wulffern/rply_ex0_sky130nm/README.md

GDS
DRC
LVS/LPE

# Why
I wanted to create a step by step "tutorial" for 
the flow. Both to debug the tech setup, and to make it easier
for you to learn the tools. I use a simple current mirror as
the example.

Head over to [https://wulffern.github.io/rply_ex0_sky130nm/](https://wulffern.github.io/rply_ex0_sky130nm/) 
for the tutorial.

# Changelog

I've tagged the repo at each stage. That means you can 
checkout the 0.1.0 tag and do things yourself.

To checkout a specific stage, do 

``` bash
git checkout 0.1.0
```

| Tag | Status | Comment |
|:---|:---|:---|
| 0.1.0 | v | Fix readme |
| 0.2.0 | v | Made schematic |
| 0.3.0 | v | Typical simulation |
| 0.4.0 | v | Corner simulation |
| 0.5.0 | v | Made layout |
| 0.6.0 | v | DRC/LVS clean |
| 0.7.0 | v | Extracted parasitics |
| 0.8.0 | v | Simulated parasitics |
| 0.9.0 | v | Updated README |
| 1.0.0 | v | All done |
| 1.0.1 | v | Updated after student feedback |

# Posts 

| File | Comment |
|:----:|---|
| [/docs/_posts/2022-12-25-tutorial.markdown](/docs/_posts/2022-12-25-tutorial.markdown) | Full tutorial |
