wulffern/rply_ex0_sky130nm/paper.md

---
abstract: |
  Tutorial on Skywater130nm open source analog flow.
author:
- Carsten Wulff
title: Open Source Analog Flow for Skywater 130nm
documentclass: docs/IEEEtran
papersize: a4
fontsize: 10pt
classoption: journal
numbersection:
pandoc-latex-fontsize:
  - classes: [c, listing]
    size: footnotesize
---
