wulffern/rply_ex0_sky130nm/docs/index.md

---
# Feel free to add content and custom Front Matter to this file.
# To modify the layout, see https://jekyllrb.com/docs/themes/#overriding-theme-defaults

layout: home
---

I've made multiple posts on a variation of topics on this page.

If you're completely new, then I'd recommend you start with the following

1. [Tech](tech)
1. [Tools](tools)
1. [Open source analog integrated circuit flow on Skywater 130 nm](tutorial)
1. [Programming](programming)

## Posts
