wulffern/rply_ex0_sky130nm/docs/_posts/2022-12-26-how-ic.markdown

---
layout: post
title: How ICs are made 
categories: AIC
---

Over the past decade I've had various lectures for 1'st year, and other levels
at NTNU with an introduction to how we make integrated circuits. I've compiled
all those slidesets over the years into a single one that I go through in these
videos. 

<iframe width="560" height="315" src="https://www.youtube.com/embed/o8XcuxAECrA" title="YouTube video player" frameborder="0" allow="accelerometer; autoplay; clipboard-write; encrypted-media; gyroscope; picture-in-picture; web-share" allowfullscreen></iframe>

<iframe width="560" height="315" src="https://www.youtube.com/embed/V5xELVCx-ZE" title="YouTube video player" frameborder="0" allow="accelerometer; autoplay; clipboard-write; encrypted-media; gyroscope; picture-in-picture; web-share" allowfullscreen></iframe>
