wulffern/rply_ex0_sky130nm/docs/_posts/2022-12-26-ieeexplore.markdown

---
layout: post
title: ieeexplore
categories: AIC
---

[ieeexplore.ieee.org](ieeexplore.ieee.org) is an online library of more than 5M
papers (bascially where all textbooks find their information). This video goes
through a few techniques on how you can search for papers on a topic you want to
learn more about.

<iframe width="560" height="315" src="https://www.youtube.com/embed/wZZnlhiIQJE" title="YouTube video player" frameborder="0" allow="accelerometer; autoplay; clipboard-write; encrypted-media; gyroscope; picture-in-picture; web-share" allowfullscreen></iframe>
