wulffern/rply_ex0_sky130nm/docs/_posts/2022-12-25-RPLY_EX0.markdown

---
layout: post
title: RPLY_EX0_SKY130NM/RPLY_EX0 simulation
permalink: rply_ex0_sim_all
categories: sim
---

Top level testbench for current mirror

### Transient analysis (tran)

Check transient operation

|**Name**|**Parameter**|**Description**| |**Min**|**Typ**|**Max**| Unit|
|:---|:---|:---|---:|:---:|:---:|:---:| ---:|
|**Output current**|**ibns\_20u** | | **Spec**  | **16.000** | **20.000** | **24.000** | **uA** |
| | | |<a href='results/tran_Sch_typical.html'>Sch_typ</a>| | 21.760 |  | |
| | | |<a href='results/tran_Sch_etc.html'>Sch_etc</a>|21.189 | 21.854 | 22.356 | |
| | | |<a href='results/tran_Sch_mc.html'>Sch_3std</a>|16.310 | 21.900 | <span style='color:red'>**27.490**</span> | |
| | | |<a href='results/tran_Lay_typical.html'>Lay_typ</a>| | 21.760 |  | |
| | | |<a href='results/tran_Lay_etc.html'>Lay_etc</a>|21.188 | 21.852 | 22.356 | |
| | | |<a href='results/tran_Lay_mc.html'>Lay_3std</a>|16.559 | 21.637 | <span style='color:red'>**26.714**</span> | |
|**Output current**|**ibns\_20u\_9n** | | **Spec**  | **16.000** | **20.000** | **24.000** | **uA** |
| | | |<a href='results/tran_Sch_typical.html'>Sch_typ</a>| | 21.760 |  | |
| | | |<a href='results/tran_Sch_etc.html'>Sch_etc</a>|21.189 | 21.854 | 22.356 | |
| | | |<a href='results/tran_Sch_mc.html'>Sch_3std</a>|16.310 | 21.900 | <span style='color:red'>**27.490**</span> | |
| | | |<a href='results/tran_Lay_typical.html'>Lay_typ</a>| | 21.759 |  | |
| | | |<a href='results/tran_Lay_etc.html'>Lay_etc</a>|21.187 | 21.851 | 22.356 | |
| | | |<a href='results/tran_Lay_mc.html'>Lay_3std</a>|16.559 | 21.636 | <span style='color:red'>**26.714**</span> | |
|**Gate-Source voltage**|**vgs\_m1** | | **Spec**  | **0.300** | **0.600** | **0.800** | **V** |
| | | |<a href='results/tran_Sch_typical.html'>Sch_typ</a>| | 0.620 |  | |
| | | |<a href='results/tran_Sch_etc.html'>Sch_etc</a>|0.511 | 0.614 | 0.711 | |
| | | |<a href='results/tran_Sch_mc.html'>Sch_3std</a>|0.608 | 0.620 | 0.631 | |
| | | |<a href='results/tran_Lay_typical.html'>Lay_typ</a>| | 0.620 |  | |
| | | |<a href='results/tran_Lay_etc.html'>Lay_etc</a>|0.511 | 0.614 | 0.711 | |
| | | |<a href='results/tran_Lay_mc.html'>Lay_3std</a>|0.611 | 0.620 | 0.629 | |
|**Current settling error**|**ibn\_settl\_err** | | **Spec**  | **-2.000** | **0.000** | **2.000** | **nA** |
| | | |<a href='results/tran_Sch_typical.html'>Sch_typ</a>| | 0.020 |  | |
| | | |<a href='results/tran_Sch_etc.html'>Sch_etc</a>|0.000 | 0.040 | 0.500 | |
| | | |<a href='results/tran_Sch_mc.html'>Sch_3std</a>|0.009 | 0.023 | 0.036 | |
| | | |<a href='results/tran_Lay_typical.html'>Lay_typ</a>| | 0.200 |  | |
| | | |<a href='results/tran_Lay_etc.html'>Lay_etc</a>|0.020 | 0.310 | <span style='color:red'>**2.410**</span> | |
| | | |<a href='results/tran_Lay_mc.html'>Lay_3std</a>|0.117 | 0.201 | 0.284 | |
