wulffern/rply_ex0_sky130nm/sim/RPLY_EX0/results/tran_Lay_mc.md

### Summary tran_Lay_mc

For details see <a href='tran_Lay_mc.html'>tran_Lay_mc.html</a>

|**Name**|**Parameter**|**View**|**Min** | **Typ** | **Max**|
|:---|:---|:---:|:---:|:---:|:---:|
|Output current|ibns\_20u | Spec | 16.000 uA | 20.000 uA | 24.000 uA |
| | | ('Lay',)|18.065 uA | 21.966 uA | 26.839 uA |
|Output current|ibns\_20u\_9n | Spec | 16.000 uA | 20.000 uA | 24.000 uA |
| | | ('Lay',)|18.065 uA | 21.966 uA | 26.839 uA |
|Gate-Source voltage|vgs\_m1 | Spec | 0.300 V | 0.600 V | 0.800 V |
| | | ('Lay',)|0.613 V | 0.621 V | 0.628 V |
|Current settling error|ibn\_settl\_err | Spec | -2.000 nA |  | 2.000 nA |
| | | ('Lay',)|0.150 nA | 0.205 nA | 0.260 nA |
