wulffern/rply_ex0_sky130nm/sim/RPLY_EX0/results/tran_Sch_etc.md

### Summary tran_Sch_etc

For details see <a href='tran_Sch_etc.html'>tran_Sch_etc.html</a>

|**Name**|**Parameter**|**View**|**Min** | **Typ** | **Max**|
|:---|:---|:---:|:---:|:---:|:---:|
|Output current|ibns\_20u | Spec | 16.000 uA | 20.000 uA | 24.000 uA |
| | | Sch|21.189 uA | 21.854 uA | 22.356 uA |
|Output current|ibns\_20u\_9n | Spec | 16.000 uA | 20.000 uA | 24.000 uA |
| | | Sch|21.189 uA | 21.854 uA | 22.356 uA |
|Gate-Source voltage|vgs\_m1 | Spec | 0.300 V | 0.600 V | 0.800 V |
| | | Sch|0.511 V | 0.614 V | 0.711 V |
|Current settling error|ibn\_settl\_err | Spec | -2.000 nA | 0.000 nA | 2.000 nA |
| | | Sch|0.000 nA | 0.040 nA | 0.500 nA |
