wulffern/rply_ex0_sky130nm/sim/RPLY_EX0/results/tran_Sch_mc.md

### Summary tran_Sch_mc

For details see <a href='tran_Sch_mc.html'>tran_Sch_mc.html</a>

|**Name**|**Parameter**|**View**|**Min** | **Typ** | **Max**|
|:---|:---|:---:|:---:|:---:|:---:|
|Output current|ibns\_20u | Spec | 16.000 uA | 20.000 uA | 24.000 uA |
| | | Sch|18.394 uA | 21.820 uA | 25.126 uA |
|Output current|ibns\_20u\_9n | Spec | 16.000 uA | 20.000 uA | 24.000 uA |
| | | Sch|18.394 uA | 21.820 uA | 25.126 uA |
|Gate-Source voltage|vgs\_m1 | Spec | 0.300 V | 0.600 V | 0.800 V |
| | | Sch|0.613 V | 0.619 V | 0.626 V |
|Current settling error|ibn\_settl\_err | Spec | -2.000 nA | 0.000 nA | 2.000 nA |
| | | Sch|0.020 nA | 0.020 nA | 0.030 nA |
