wulffern/rply_ex0_sky130nm/sim/RPLY_EX0/results/tran_Sch_typical.md

### Summary tran_Sch_typical

For details see <a href='tran_Sch_typical.html'>tran_Sch_typical.html</a>

|**Name**|**Parameter**|**View**|**Min** | **Typ** | **Max**|
|:---|:---|:---:|:---:|:---:|:---:|
|Output current|ibns\_20u | Spec | 16.000 uA | 20.000 uA | 24.000 uA |
| | | Sch|21.138 uA | 21.138 uA | 21.138 uA |
|Gate-Source voltage|vgs\_m1 | Spec | 0.300 V | 0.600 V | 0.700 V |
| | | Sch|0.659 V | 0.659 V | 0.659 V |
