wulffern/rply_ex0_sky130nm/sim/RPLY_EX0/results/tran_Lay_mc.csv

 | ibns_20u | ibns_20u_9n | vgs_m1 | ibn_settl_err | name | type | time | OK
0 | 22.87332 | 22.873089999999998 | 0.6245749 | 0.2300000000025372 | tran_LayGtAmcttTtVt_29 | Lay | Sat Jan 27 14:00:58 2024 | True
1 | 24.37787 | 24.37763 | 0.6274801 | 0.2399999999998486 | tran_LayGtAmcttTtVt_28 | Lay | Sat Jan 27 14:00:58 2024 | False
2 | 18.931189999999997 | 18.93103 | 0.6147707 | 0.15999999999764034 | tran_LayGtAmcttTtVt_27 | Lay | Sat Jan 27 14:00:58 2024 | True
3 | 24.35388 | 24.35367 | 0.6225793 | 0.20999999999774996 | tran_LayGtAmcttTtVt_26 | Lay | Sat Jan 27 14:00:58 2024 | False
4 | 20.18949 | 20.189329999999998 | 0.6165039 | 0.16000000000102846 | tran_LayGtAmcttTtVt_25 | Lay | Sat Jan 27 14:00:58 2024 | True
5 | 23.67546 | 23.67523 | 0.624218 | 0.2300000000025372 | tran_LayGtAmcttTtVt_24 | Lay | Sat Jan 27 14:00:58 2024 | True
6 | 25.07651 | 25.07626 | 0.6244305 | 0.2500000000005482 | tran_LayGtAmcttTtVt_23 | Lay | Sat Jan 27 14:00:58 2024 | False
7 | 23.12878 | 23.12855 | 0.6207265 | 0.22999999999914908 | tran_LayGtAmcttTtVt_22 | Lay | Sat Jan 27 14:00:58 2024 | True
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
