wulffern/rply_ex0_sky130nm/sim/RPLY_EX0/results/tran_Sch_mc.csv

 | ibns_20u | ibns_20u_9n | vgs_m1 | ibn_settl_err | name | type | time | OK
0 | 22.39274 | 22.39272 | 0.6233212 | 0.019999999998010977 | tran_SchGtAmcttTtVt_29 | Sch | Tue Dec 20 23:11:30 2022 | True
1 | 24.03168 | 24.03165 | 0.6244013 | 0.03000000000209866 | tran_SchGtAmcttTtVt_28 | Sch | Tue Dec 20 23:11:30 2022 | False
2 | 23.72462 | 23.72459 | 0.6227399 | 0.03000000000209866 | tran_SchGtAmcttTtVt_27 | Sch | Tue Dec 20 23:11:30 2022 | True
3 | 20.61161 | 20.61159 | 0.6170667 | 0.019999999998010977 | tran_SchGtAmcttTtVt_26 | Sch | Tue Dec 20 23:11:30 2022 | True
4 | 19.06183 | 19.061809999999998 | 0.6150949 | 0.020000000001399107 | tran_SchGtAmcttTtVt_25 | Sch | Tue Dec 20 23:11:30 2022 | True
5 | 19.8054 | 19.80538 | 0.618771 | 0.019999999998010977 | tran_SchGtAmcttTtVt_24 | Sch | Tue Dec 20 23:11:30 2022 | True
6 | 18.39399 | 18.39397 | 0.6126176 | 0.020000000001399107 | tran_SchGtAmcttTtVt_23 | Sch | Tue Dec 20 23:11:30 2022 | True
7 | 24.67434 | 24.67431 | 0.6211329 | 0.03000000000209866 | tran_SchGtAmcttTtVt_22 | Sch | Tue Dec 20 23:11:30 2022 | False
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
