wulffern/rply_ex0_sky130nm/(commit log)

2022-12-20 Made RPLY_EX0_SKY130NM
    [RPLY_EX0.sch]
2022-12-20 Added schematic
    [RPLY_EX0.sch]
2022-12-20 Typical simulation added
    [RPLY_EX0.sch, tran_Sch_typical.csv]
2022-12-20 Updated corner simulation
    [tran_Sch_etc.csv, tran_Sch_mc.csv, tran_Sch_typical.csv]
2022-12-20 Added parasitics
    [RPLY_EX0.sch]
2022-12-20 Ran extracted sim
    [tran_Lay_etc.csv, tran_Lay_mc.csv, tran_Lay_typical.csv, tran_Sch_etc.csv, tran_Sch_mc.csv, tran_Sch_typical.csv]
2023-01-13 Added docker on windows
    [tran_Lay_typical.csv]
2023-01-17 Added FAQ
    [tran_Lay_typical.csv]
2023-01-22 Updated tools
    [tran_Lay_typical.csv]
2023-02-24 fixed config for mathjax
    [tran_Lay_typical.csv]
2024-01-27 Updated tutorial based on 2024 feedback
    [tran_Lay_etc.csv, tran_Lay_mc.csv, tran_Lay_typical.csv]
2024-09-18 Added test
    [tran_Lay_typical.csv]
